Surgical-Lighting-MIT-2-75-2024/SurgicalLightBatteryModule/Rev B/Rev 2.0.pdf

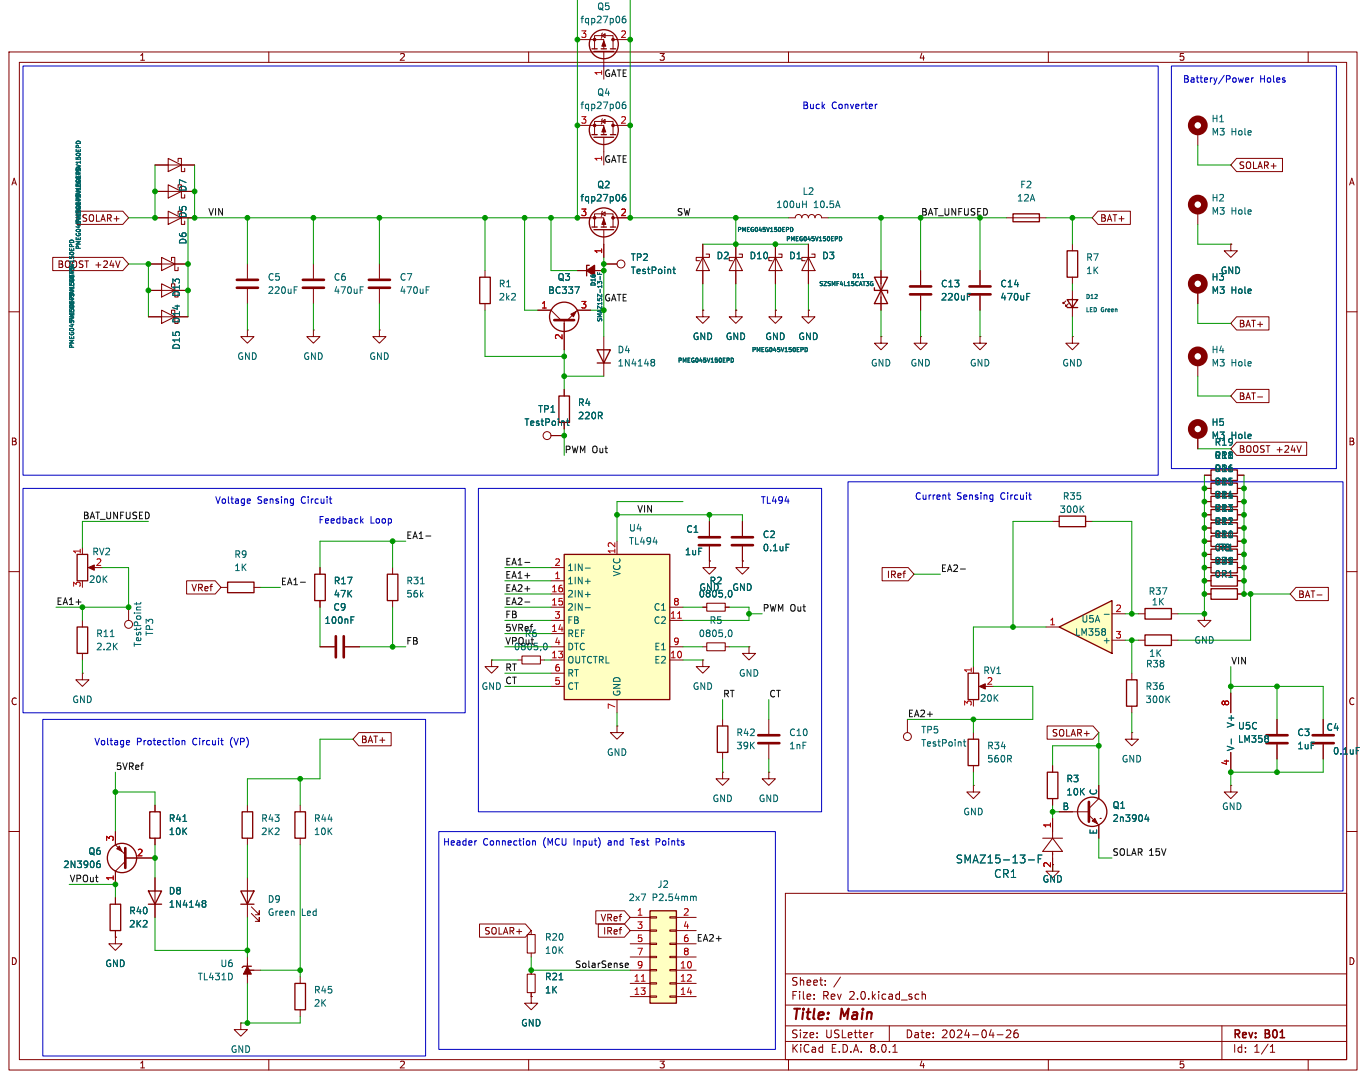
[picture p1: page 1]

GATE GATE GATE GATE GATE

0R1 H5 M3 Hole H3 M3 Hole GND GND CR1

File: Rev 2.0.kicad_sch Sheet: / GND
