Surgical-Lighting-MIT-2-75-2024/SurgicalLightBatteryModule/Rev B/LightBatteryModule.kicad_pcb

## KiCad design Rev B/LightBatteryModule.kicad_pcb (2024-05-02)

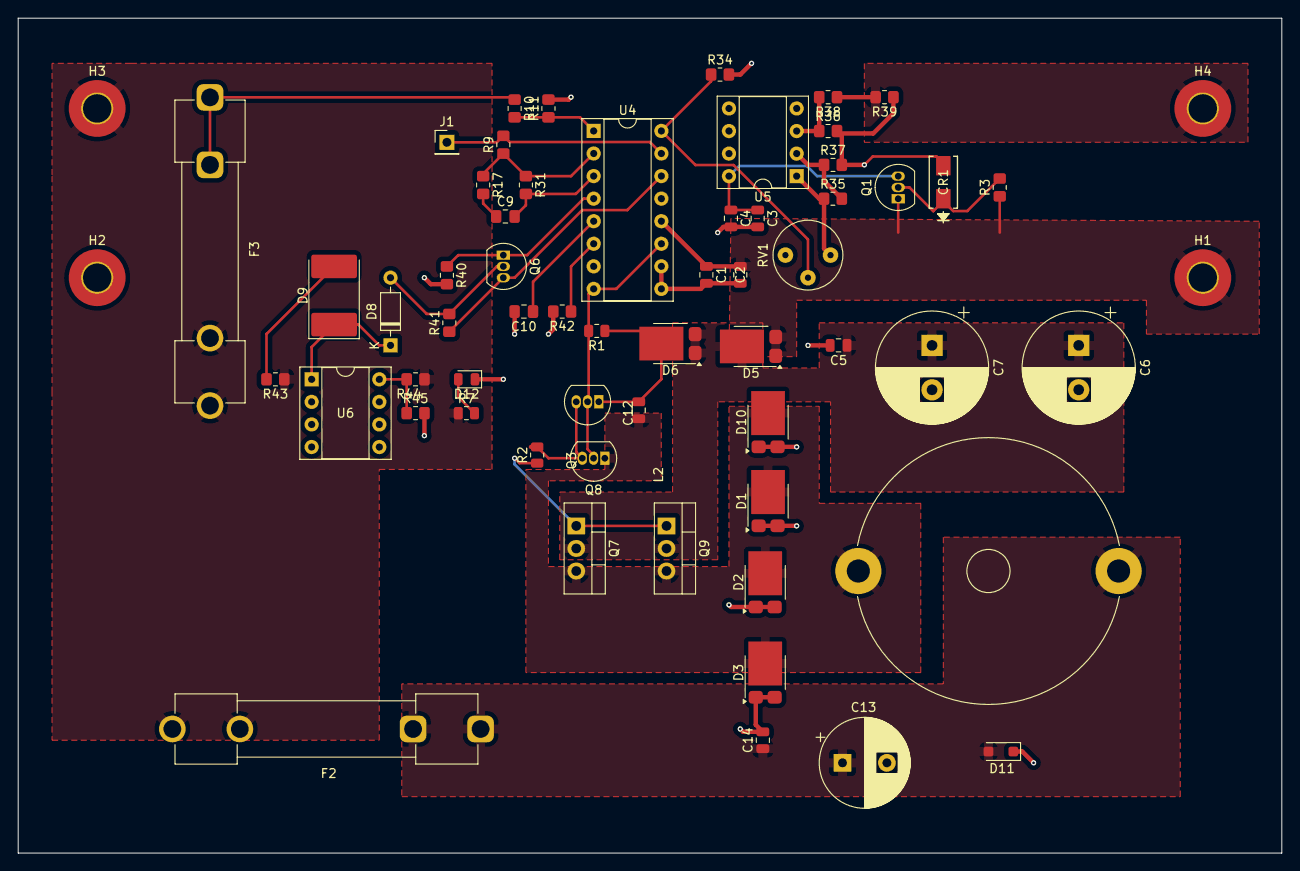
[picture p2: board LightBatteryModule.kicad_pcb from above]

Board: 2 copper layers, 142.2 x 94.0 mm, 62 parts (0 on the bottom side), 32 nets.

Parts:
C1, C3: 1uF; C_0805_2012Metric
C2, C4, C5, C12, C14: 0.1uF; C_0805_2012Metric
C6, C7: 470uF; CP_Radial_D12.5mm_P5.00mm
C9: 100nF; C_0805_2012Metric_Pad1.18x1.45mm_HandSolder
C10: 1nF; C_0805_2012Metric_Pad1.18x1.45mm_HandSolder
C13: 22uF; CP_Radial_D10.0mm_P5.00mm
CR1: SMAZ15-13-F; SMA_DIO
D1, D2, D3, D5, D6, D10: PMEG045V150EPD; Nexperia_CFP15_SOT-1289
D8: 1N4148; D_DO-35_SOD27_P7.62mm_Horizontal
D9: LED; D_3220_8050Metric_Pad2.65x5.15mm_HandSolder
D11: SZSMF4L15CAT3G; D_SOD-123F
D12: LED Green; LED_0805_2012Metric
F2, F3: 12A; Fuseholder_Clip-6.3x32mm_Littelfuse_102071_Inline_P34.70x7.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
H1, H2, H3, H4: M3 Hole; MountingHole_3.2mm_M3_Pad_TopBottom
J1: Conn_01x01_Pin; PinHeader_1x01_P2.54mm_Vertical
L2: 100uH 10.5A; L_Radial_D29.8mm_P29.30mm_Murata_1400series
Q1: 2n3904; TO-92_Inline
Q3: BC337; TO-92_Inline
Q6: BC557; TO-92_Inline
Q7, Q9: IRLZ44N; TO-220-3_Vertical
Q8: BC327; TO-92_Inline
R1: 2k2; R_0805_2012Metric
R2: 5; R_0805_2012Metric
R3, R10, R41, R44: 10K; R_0805_2012Metric_Pad1.20x1.40mm_HandSolder
R7: 1K; R_0805_2012Metric
R9: 1K; R_0805_2012Metric_Pad1.20x1.40mm_HandSolder
R11: 2.2K; R_0805_2012Metric_Pad1.20x1.40mm_HandSolder
R17, R35, R36: 47K; R_0805_2012Metric_Pad1.20x1.40mm_HandSolder
R31: 56k; R_0805_2012Metric_Pad1.20x1.40mm_HandSolder
R34: 560R; R_0805_2012Metric_Pad1.20x1.40mm_HandSolder
R37, R38, R45: 2K; R_0805_2012Metric_Pad1.20x1.40mm_HandSolder
R39: 0R1; R_0805_2012Metric_Pad1.20x1.40mm_HandSolder
R40, R43: 2K2; R_0805_2012Metric_Pad1.20x1.40mm_HandSolder
R42: 39K; R_0805_2012Metric_Pad1.20x1.40mm_HandSolder
RV1: 10K; Potentiometer_Bourns_3339P_Vertical_HandSoldering
U4: TL494; DIP-16_W7.62mm_Socket
U5: LM358; DIP-8_W7.62mm_Socket
U6: TL431D; DIP-8_W7.62mm_Socket

Connections:
/CT: C10.1, U4.5 (CT)
/EA1+: R10.2, R11.1, U4.1 (1IN+)
/EA1-: R9.1, R17.1, R31.1, U4.2 (1IN-)
/EA2+: R34.1, RV1.2, U4.16 (2IN+)
/FB: C9.2, R31.2, U4.3 (FB)
/PWM Out: Q3.2 (B), Q8.2 (B), R1.2, U4.8 (C1), U4.11 (C2)
/RT: R42.1, U4.6 (RT)
/SOLAR 15V: C3.1, C4.1, Q1.3 (E), U5.8 (V+)
/VPOut: Q6.1 (C), R40.1, U4.4 (DTC)
/VREF: Q6.3 (E), R41.1, U4.14 (REF)
BAT+: F2.2, F3.2, H3.1, R7.1, R43.1, R44.1
BAT-: H4.1, R38.1, R39.2
GND: C1.2, C2.2, C3.2, C4.2, C5.2, C6.2, C7.2, C10.2, C13.2, C14.2, CR1.2, D1.1 (A), D1.2 (A), D2.1 (A), D2.2 (A), D3.1 (A), D3.2 (A), D10.1 (A), D10.2 (A), D11.1 (A1), D12.1 (K), H2.1, R11.2, R34.2, R36.2, R37.2, R39.1, R40.2, R42.2, R45.2, U4.7 (GND), U4.9 (E1), U4.10 (E2), U4.13 (OUTCTRL), U5.4 (V-), U6.2 (A), U6.3 (A), U6.6 (A), U6.7 (A)
MCU 2.5V: J1.1, R9.2, U4.15 (2IN-)
unnamed: C9.1, R17.2
unnamed: C12.2, D1.3 (K), D2.3 (K), D3.3 (K), D10.3 (K), L2.1, Q7.3 (S), Q8.1 (C), Q9.3 (S)
unnamed: C5.1, C6.1, C7.1, D5.3 (K), D6.1 (A), D6.2 (A), Q7.2 (D), Q9.2 (D)
unnamed: C12.1, D6.3 (K), Q3.1 (C), R1.1
unnamed: D8.2 (A), Q6.2 (B), R41.2
unnamed: D8.1 (K), D9.1 (K), U6.1 (K)
unnamed: D9.2 (A), R43.2
unnamed: C13.1, C14.1, D11.2 (A2), F2.1, L2.2
unnamed: D12.2 (A), R7.2
unnamed: F3.1, R10.1
unnamed: CR1.1, Q1.2 (B), R3.2
unnamed: Q3.3 (E), Q8.3 (E), R2.2
unnamed: Q7.1 (G), Q9.1 (G), R2.1
unnamed: R35.1, RV1.1, U5.1
unnamed: R36.1, R38.2, U5.3 (+)
unnamed: R35.2, R37.1, U5.2 (-)
unnamed: R44.2, R45.1, U6.8 (REF)
SOLAR+: C1.1, C2.1, D5.1 (A), D5.2 (A), H1.1, Q1.1 (C), R3.1, U4.12 (VCC)
