Surgical-Lighting-MIT-2-75-2024/SurgicalLightBatteryModule/Version-04-03-2024/SurgicalLightBatteryModule (first version).kicad_pcb

## KiCad design Version-04-03-2024/SurgicalLightBatteryModule (first version).kicad_pcb (2024-04-03)

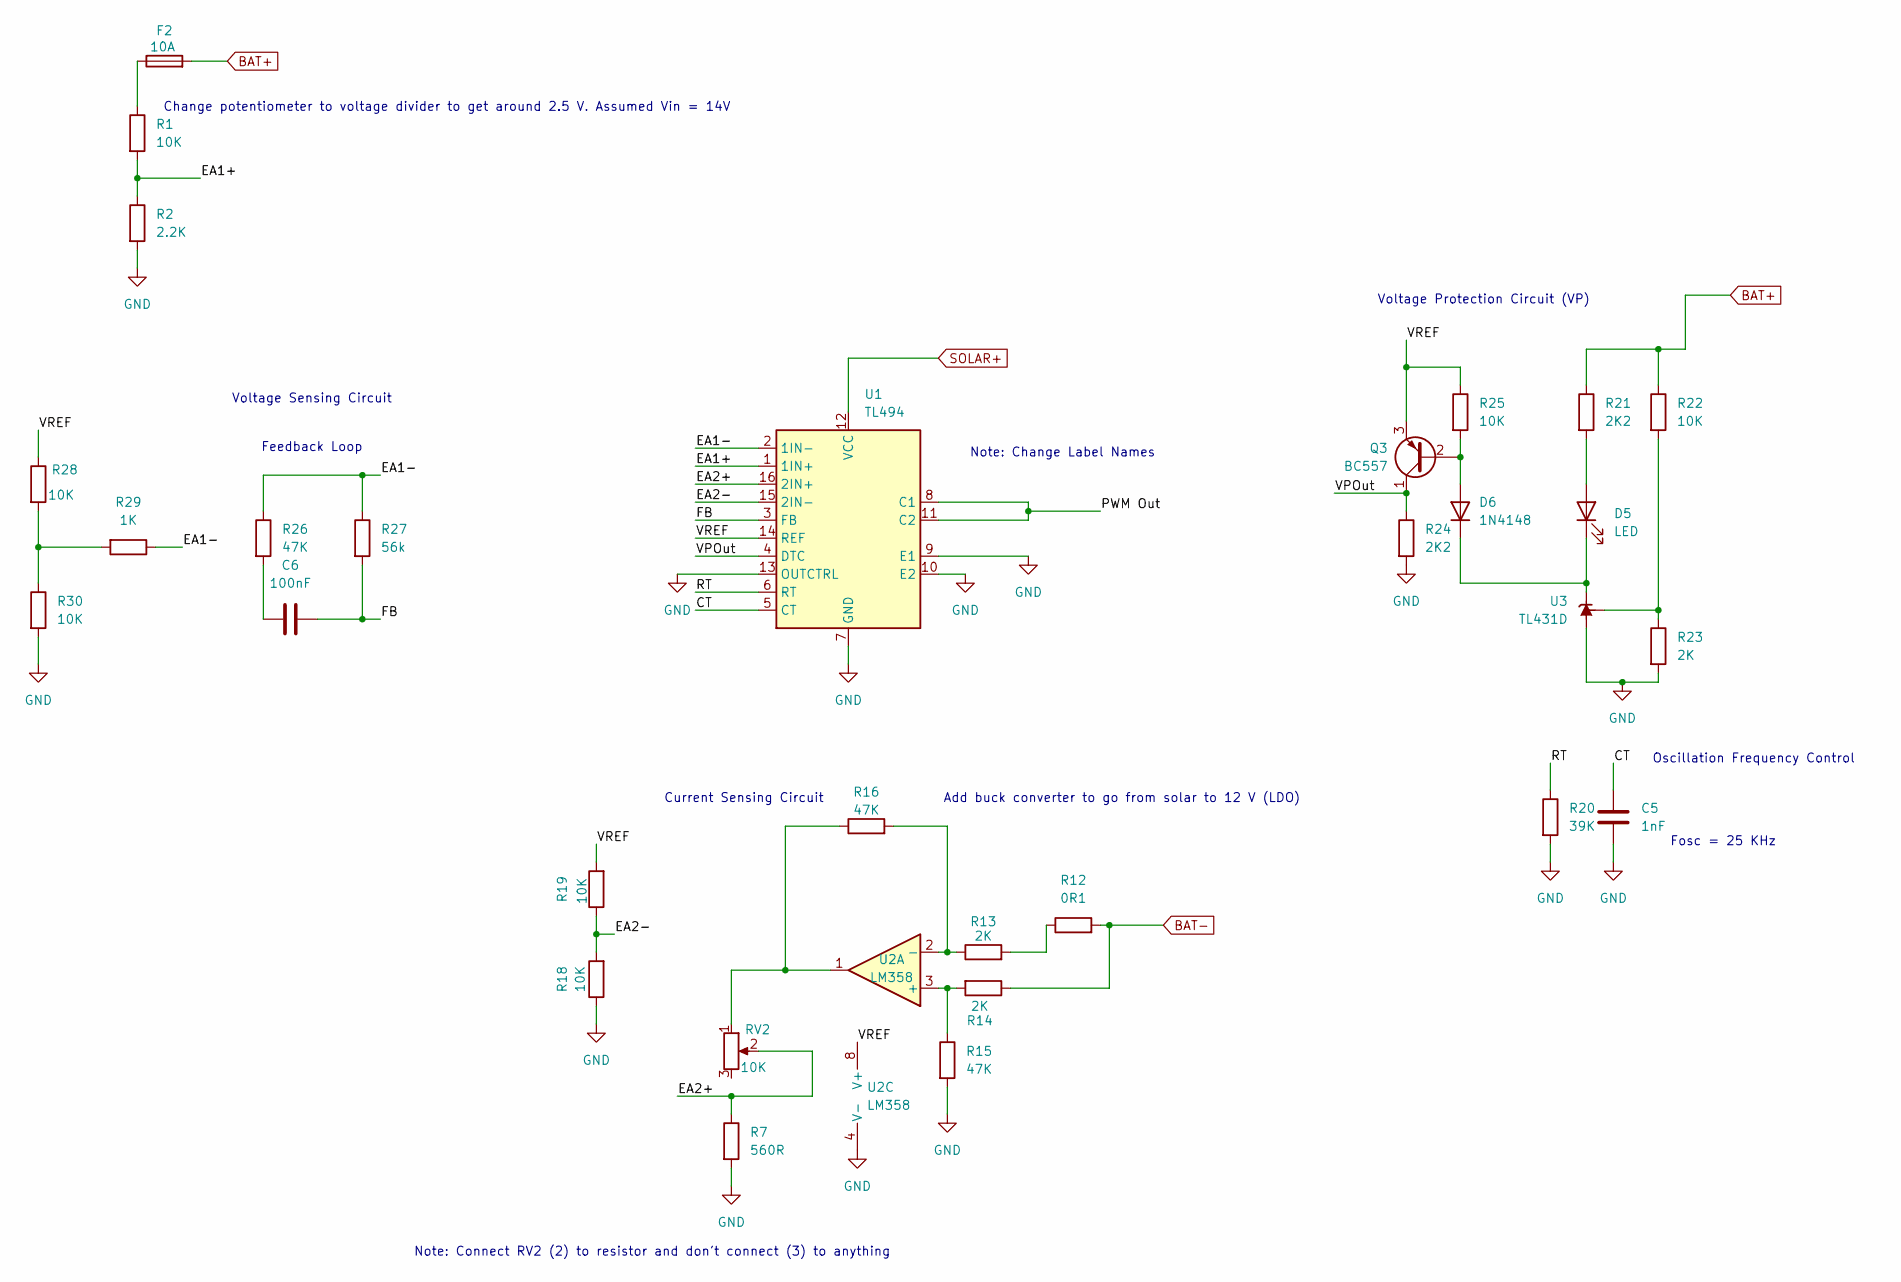
[picture p3: schematic battery_module_analog.kicad_sch]

Parts:
C5: 1nF; C_0805_2012Metric_Pad1.18x1.45mm_HandSolder
C6: 100nF; C_0805_2012Metric_Pad1.18x1.45mm_HandSolder
D5: LED; D_3220_8050Metric_Pad2.65x5.15mm_HandSolder
D6: 1N4148; D_DO-35_SOD27_P7.62mm_Horizontal
F2: 10A; Fuse_0805_2012Metric_Pad1.15x1.40mm_HandSolder
Q3: BC557; TO-92_Inline
R1, R18, R19, R22, R25, R28, R30: 10K; R_0805_2012Metric_Pad1.20x1.40mm_HandSolder
R2: 2.2K; R_0805_2012Metric_Pad1.20x1.40mm_HandSolder
R7: 560R; R_0805_2012Metric_Pad1.20x1.40mm_HandSolder
R12: 0R1; R_0805_2012Metric_Pad1.20x1.40mm_HandSolder
R13, R14, R23: 2K; R_0805_2012Metric_Pad1.20x1.40mm_HandSolder
R15, R16, R26: 47K; R_0805_2012Metric_Pad1.20x1.40mm_HandSolder
R20: 39K; R_0805_2012Metric_Pad1.20x1.40mm_HandSolder
R21, R24: 2K2; R_0805_2012Metric_Pad1.20x1.40mm_HandSolder
R27: 56k; R_0805_2012Metric_Pad1.20x1.40mm_HandSolder
R29: 1K; R_0805_2012Metric_Pad1.20x1.40mm_HandSolder
RV2: 10K; Potentiometer_Bourns_3339P_Vertical_HandSoldering
U1: TL494; DIP-16_W7.62mm_Socket
U2: LM358; DIP-8_W7.62mm_Socket
U3: TL431D; SOIC-8_3.9x4.9mm_P1.27mm

Connections:
/battery_module_analog/CT: C5.1, U1.5 (CT)
/battery_module_analog/EA1+: R1.2, R2.1, U1.1 (1IN+)
/battery_module_analog/EA1-: R26.1, R27.1, R29.1, U1.2 (1IN-)
/battery_module_analog/EA2+: R7.1, RV2.2, U1.16 (2IN+)
/battery_module_analog/EA2-: R18.2, R19.1, U1.15 (2IN-)
/battery_module_analog/FB: C6.2, R27.2, U1.3 (FB)
/battery_module_analog/PWM Out: U1.8 (C1), U1.11 (C2)
/battery_module_analog/RT: R20.1, U1.6 (RT)
/battery_module_analog/VPOut: Q3.1 (C), R24.1, U1.4 (DTC)
/battery_module_analog/VREF: Q3.3 (E), R19.2, R25.1, R28.1, U1.14 (REF), U2.8 (V+)
BAT+: F2.2, R21.1, R22.1
BAT-: R12.2, R14.1
GND: C5.2, R2.2, R7.2, R15.2, R18.1, R20.2, R23.2, R24.2, R30.2, U1.7 (GND), U1.9 (E1), U1.10 (E2), U1.13 (OUTCTRL), U2.4 (V-), U3.2 (A), U3.3 (A), U3.6 (A), U3.7 (A); also elsewhere on the board
unnamed: C6.1, R26.2
unnamed: D5.2 (A), R21.2
unnamed: D5.1 (K), D6.1 (K), U3.1 (K)
unnamed: D6.2 (A), Q3.2 (B), R25.2
unnamed: F2.1, R1.1
unnamed: R12.1, R13.2
unnamed: R16.1, RV2.1, U2.1
unnamed: R28.2, R29.2, R30.1
unnamed: R14.2, R15.1, U2.3 (+)
unnamed: R13.1, R16.2, U2.2 (-)
unnamed: R22.2, R23.1, U3.8 (REF)
SOLAR+: U1.12 (VCC)

Notes on the sheet:
Voltage Sensing Circuit
Change potentiometer to voltage divider to get around 2.5 V. Assumed Vin = 14V
Add buck converter to go from solar to 12 V (LDO)
Oscillation Frequency Control
Fosc = 25 KHz
Voltage Protection Circuit (VP)
Note: Connect RV2 (2) to resistor and don't connect (3) to anything
Feedback Loop
Current Sensing Circuit
Note: Change Label Names

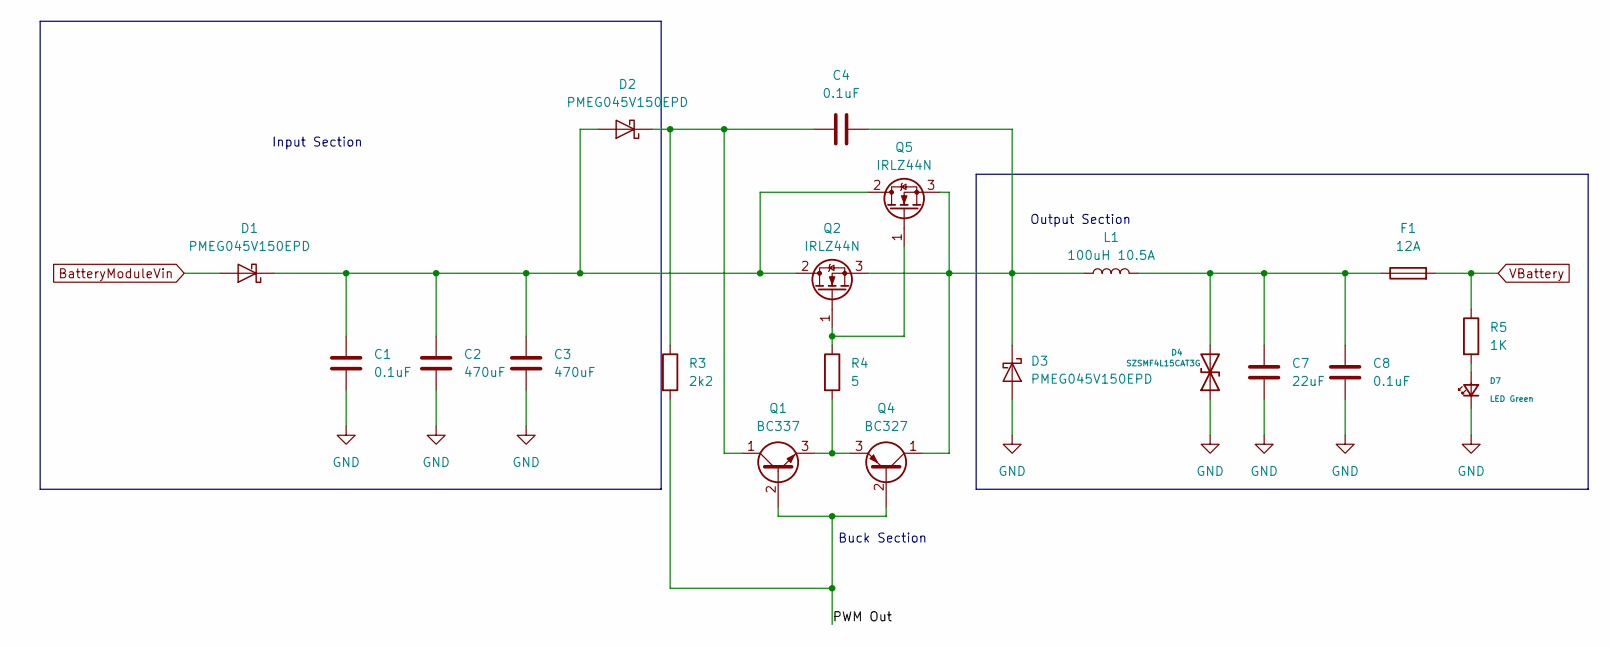
[picture p4: schematic battery_module_power.kicad_sch]

Parts:
C1, C4, C8: 0.1uF; C_0805_2012Metric
C2, C3: 470uF; C_0805_2012Metric_Pad1.18x1.45mm_HandSolder
C7: 22uF; C_0805_2012Metric_Pad1.18x1.45mm_HandSolder
D1, D2, D3: PMEG045V150EPD; Nexperia_CFP15_SOT-1289
D4: SZSMF4L15CAT3G; D_SOD-123F
D7: LED Green; LED_0805_2012Metric
F1: 12A; Fuse_0805_2012Metric_Pad1.15x1.40mm_HandSolder
L1: 100uH 10.5A; L_0805_2012Metric
Q1: BC337; TO-92_Inline
Q2, Q5: IRLZ44N; TO-220-3_Vertical
Q4: BC327; TO-92_Inline
R3: 2k2; R_0805_2012Metric
R4: 5; R_0805_2012Metric
R5: 1K; R_0805_2012Metric

Connections:
/battery_module_power/PWM Out: Q1.2 (B), Q4.2 (B), R3.2
BatteryModuleVin: D1.1 (A), D1.2 (A)
GND: C1.2, C2.2, C3.2, C7.2, C8.2, D3.1 (A), D3.2 (A), D4.1 (A1), D7.1 (K); also elsewhere on the board
unnamed: C1.1, C2.1, C3.1, D1.3 (K), D2.1 (A), D2.2 (A), Q2.2 (D), Q5.2 (D)
unnamed: C4.1, D2.3 (K), Q1.1 (C), R3.1
unnamed: C4.2, D3.3 (K), L1.1, Q2.3 (S), Q4.1 (C), Q5.3 (S)
unnamed: C7.1, C8.1, D4.2 (A2), F1.1, L1.2
unnamed: D7.2 (A), R5.2
unnamed: Q1.3 (E), Q4.3 (E), R4.2
unnamed: Q2.1 (G), Q5.1 (G), R4.1
VBattery: F1.2, R5.1

Notes on the sheet:
Output Section
Buck Section
Input Section

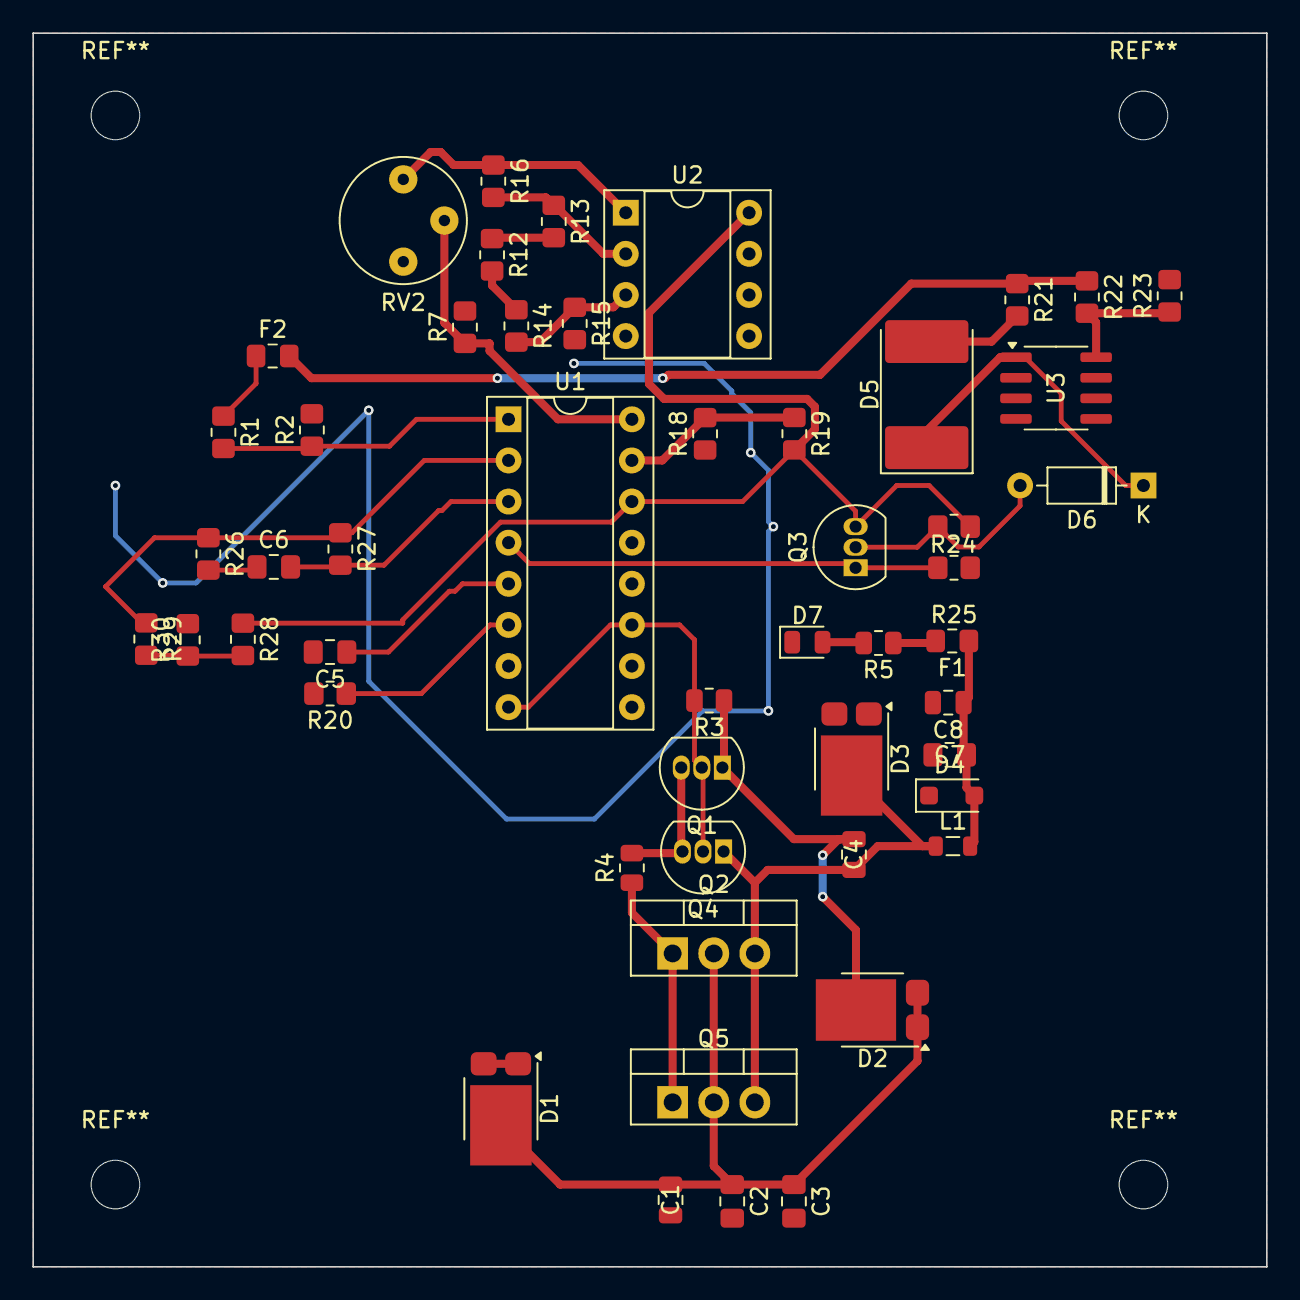
[picture p5: board SurgicalLightBatteryModule (first version).kicad_pcb from above]

Board: 2 copper layers, 76.2 x 76.2 mm, 51 parts (0 on the bottom side), 34 nets.
