Surgical-Lighting-MIT-2-75-2024/SurgicalLightBatteryModule/(commit log)

2024-03-21 First commit.
    [SurgicalLightBatteryModule.kicad_pcb, SurgicalLightBatteryModule.kicad_sch, battery_module_analog.kicad_sch, battery_module_power.kicad_sch]
2024-03-24 Added buck converter schematic.
    [SurgicalLightBatteryModule.kicad_sch, battery_module_power.kicad_sch]
2024-03-24 Used push-pull BJT circuit to drive MOSFET.
    [battery_module_power.kicad_sch]
2024-03-25 Analog MPPT
    Current sensing and voltage sensing circuits that go into the TL494 to change the PWM signal that will go into the buck converter. This schematic shows how to change the oscillation frequency of the TL494 and also provides a Voltage Protection to shut down all outputs of the TL494 in case of voltage spike.
    [battery_module_analog.kicad_sch]
2024-03-26 Analog MPPT (Latest Update)
    Cleaned connections.
    [battery_module_analog.kicad_sch]
2024-03-26 Updated MPPT
    [battery_module_analog.kicad_sch]
2024-03-28 Updated buck.
    [battery_module_power.kicad_sch]
2024-03-31 mppt schematic (03/30/2024)
    Used 5V to power up op amp. Changed configurations of potentiometers.
    [battery_module_analog.kicad_sch]
2024-04-26 Rev 2.0 (updated)
    [Rev 2.0.kicad_pcb, Rev 2.0.kicad_sch, bom.csv, designators.csv, positions.csv]
2024-04-27 Reverted BAT- hole position
    [Rev 2.0.kicad_pcb]
